cobanov/cyberdeck/cyberdeck.FCStd

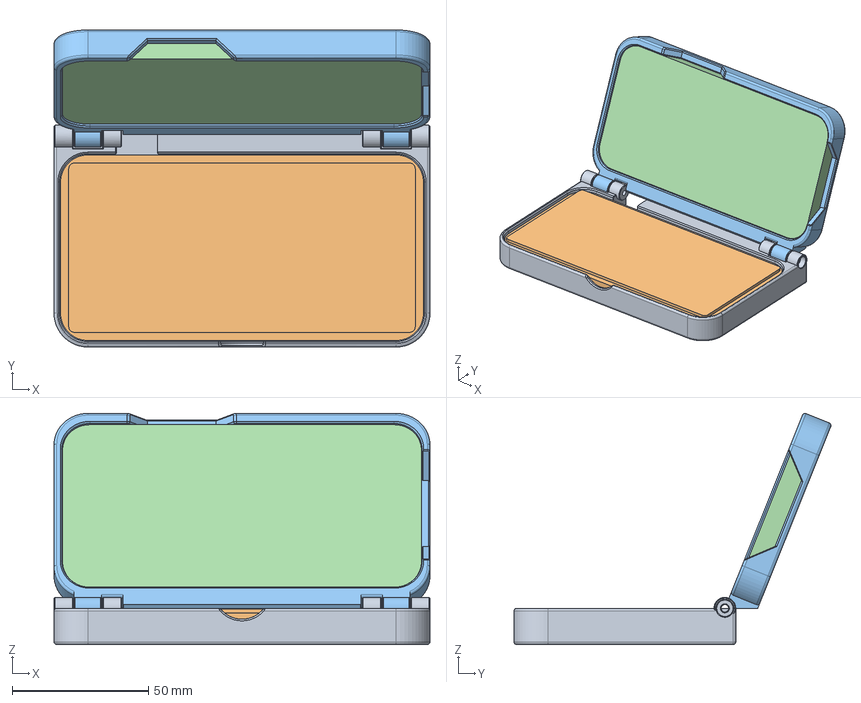
[picture p3: CAD file, 2026-11-02]
cyberdeck.FCStd
137.8 x 116.2 x 84.7 mm
Base
Keyboard
Lid
Phone
