cobanov/cyberdeck/render/lid.stl

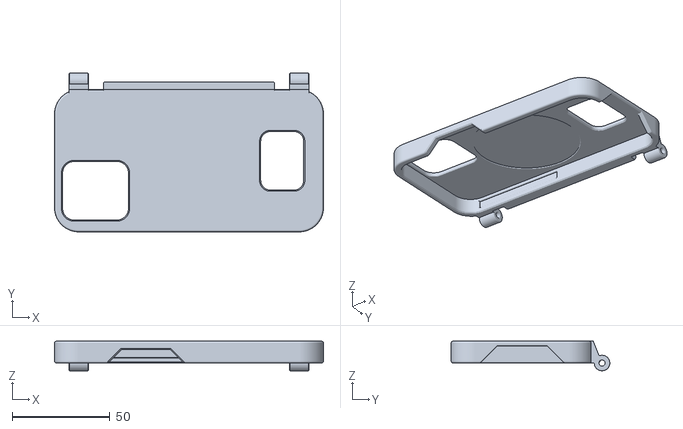
[picture p4: CAD file, 2026-11-02]
render/lid.stl
137.8 x 81.3 x 15.2
