cobanov/cyberdeck/render/slate/slate.stl

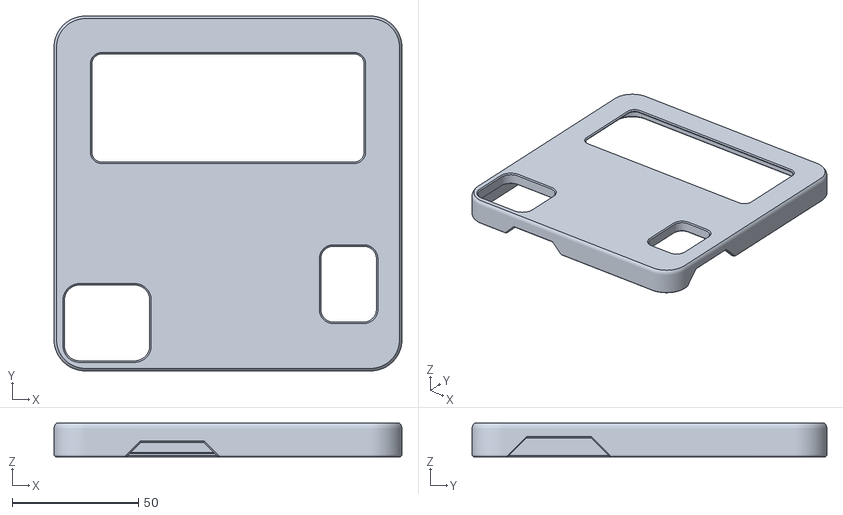
[picture p5: CAD file, 2026-11-02]
render/slate/slate.stl
137.8 x 140.5 x 13.4
