cobanov/cyberdeck/render/slide-in/phone.stl

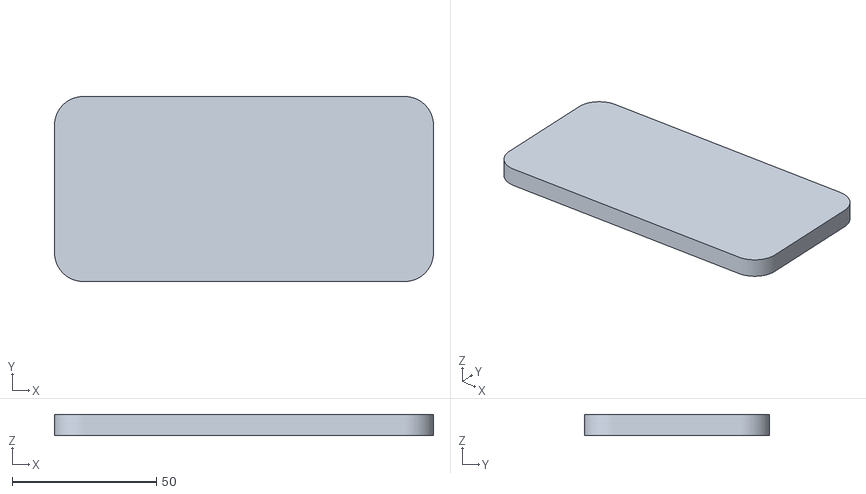
[picture p6: CAD file, 2026-10-31]
render/slide-in/phone.stl
131.5 x 64.2 x 7.40
