cobanov/cyberdeck/render/slide-in/slate/slate.stl

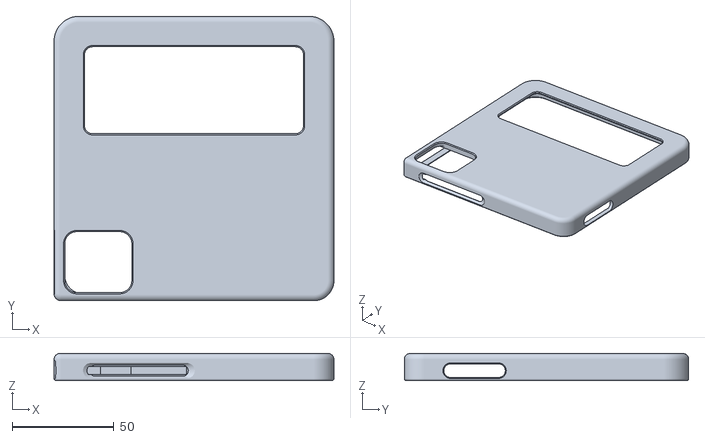
[picture p7: CAD file, 2026-11-01]
render/slide-in/slate/slate.stl
137.8 x 140.0 x 13.4
