cobanov/cyberdeck/stl/slide-in/slate.stl

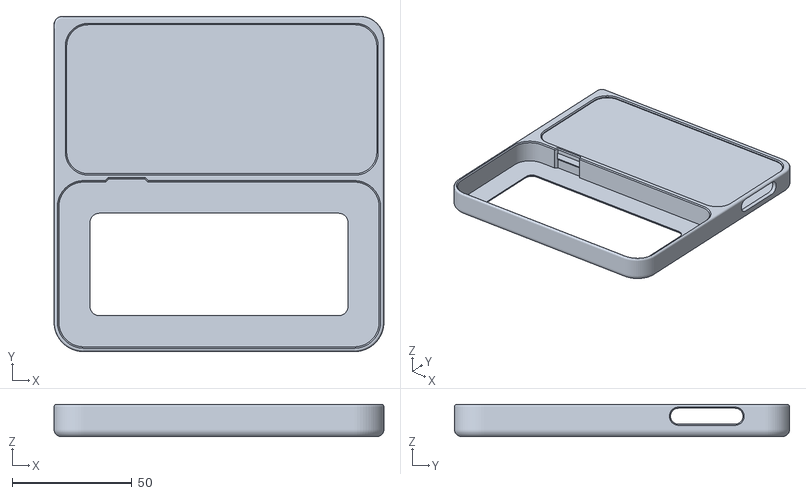
[picture p8: CAD file, 2026-11-01]
stl/slide-in/slate.stl
137.8 x 140.0 x 13.4
