cobanov/cyberdeck/render/base.stl

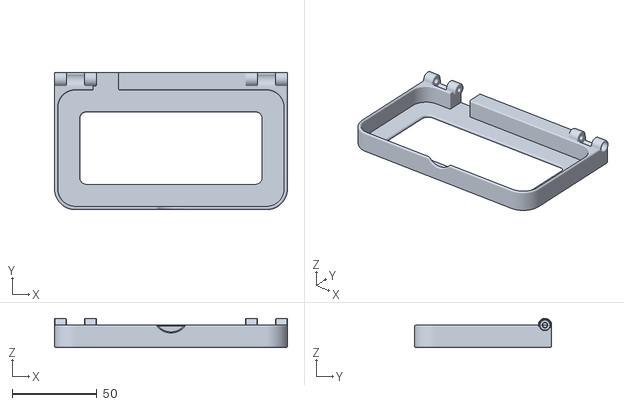
[picture p9: CAD file, 2026-11-01]
render/base.stl
137.8 x 81.3 x 17.3
