cobanov/cyberdeck/render/slide-in/lid.stl

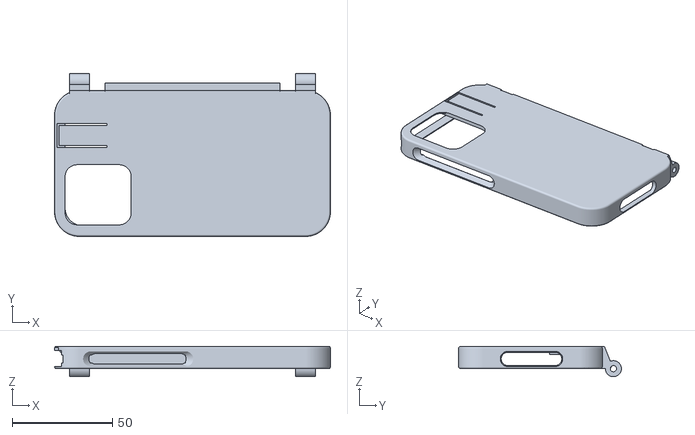
[picture p10: CAD file, 2026-10-31]
render/slide-in/lid.stl
137.8 x 81.3 x 15.2
