cobanov/cyberdeck/slate.FCStd

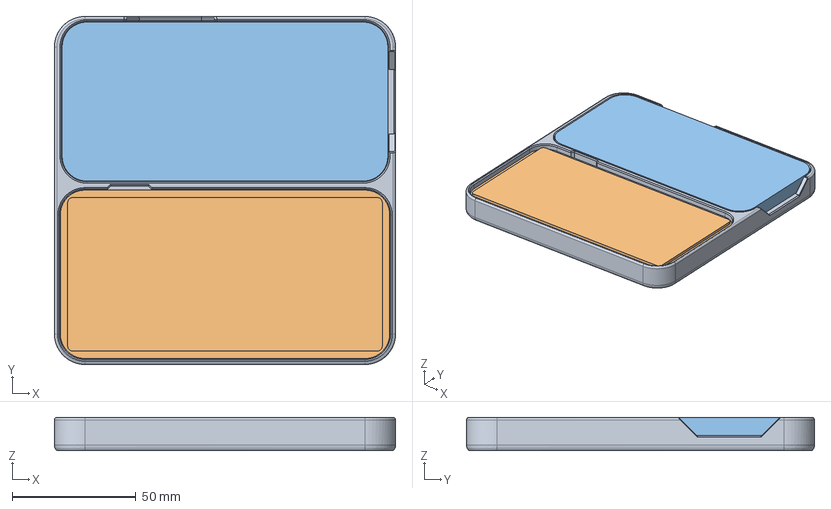
[picture p11: CAD file, 2026-11-02]
slate.FCStd
137.8 x 140.5 x 13.4 mm
Keyboard
Phone
