cobanov/cyberdeck/render/slate/kb_body.stl

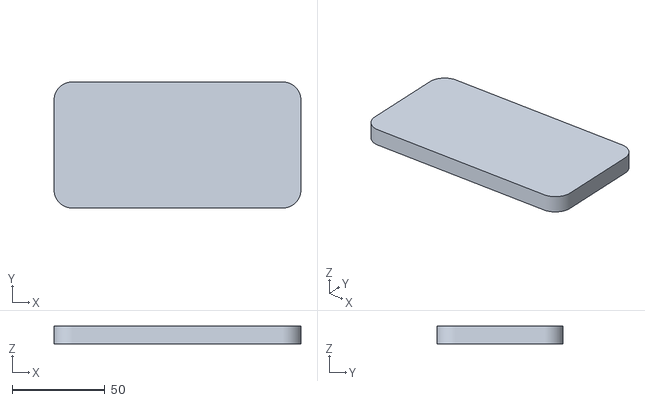
[picture p12: CAD file, 2026-11-01]
render/slate/kb_body.stl
133.0 x 68.0 x 9.50
