cobanov/cyberdeck/stl/fit_keyboard.stl

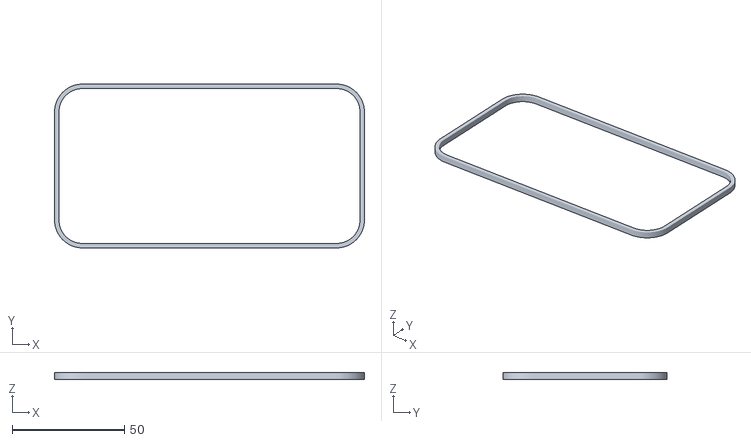
[picture p13: CAD file, 2026-10-29]
stl/fit_keyboard.stl
137.8 x 72.8 x 3.00
