cobanov/cyberdeck/stl/radius_gauge_case.stl

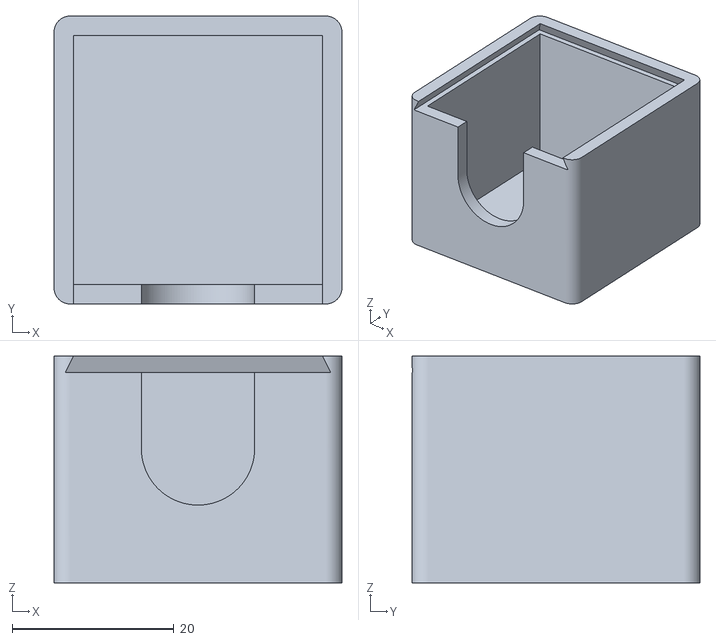
[picture p14: CAD file, 2026-10-29]
stl/radius_gauge_case.stl
35.6 x 35.6 x 28.0
