cobanov/cyberdeck/stl/radius_gauge_lid.stl

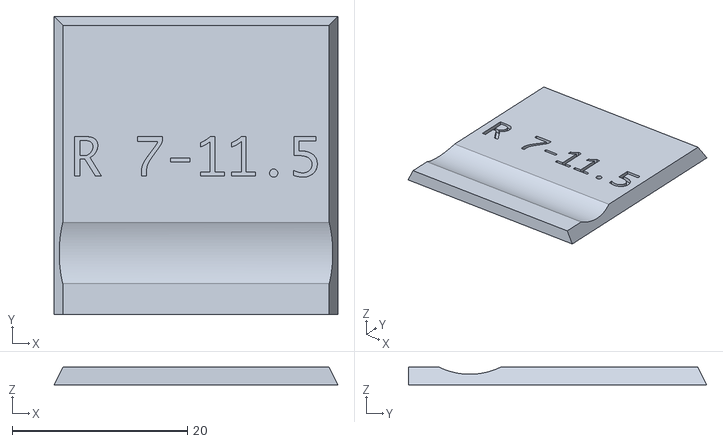
[picture p15: CAD file, 2026-10-29]
stl/radius_gauge_lid.stl
32.4 x 34.0 x 2.00
