cobanov/cyberdeck/stl/radius_gauge.stl

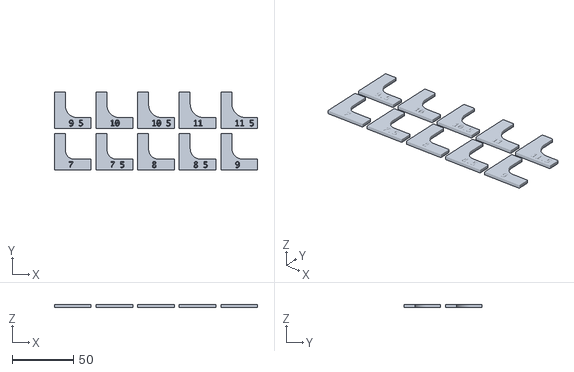
[picture p16: CAD file, 2026-10-28]
stl/radius_gauge.stl
166.0 x 64.0 x 2.40
