cobanov/cyberdeck/(list of files, cad)

Other CAD files:
stl/lid.stl
render/slate/phone.stl
render/slide-in/slate/phone.stl
stl/base.stl
stl/slide-in/lid.stl
render/phone.stl
render/kb_body.stl
stl/slate.stl
