cobanov/cyberdeck/(commit log)

2026-10-28 Clamshell cyberdeck for a Torima M7 keyboard and an iPhone 12 mini
    Parametric FreeCAD case: keyboard tray with a USB-C channel through the
    hinge foot, lid with slide-in rails and a flexing latch, two M3 screw
    hinges with a hard stop at 112 degrees. Self-checks assert the swing,
    the stop and both fits. Adds fit-test parts, a corner radius gauge, and
    a Blender room render built from the same meshes.
    Claude-Session: https://claude.ai/code/session_01PjqH8uNenf2NogwZJGJHBp
    [base.stl, cyberdeck.FCStd, cyberdeck.blend, fit_keyboard.stl, fit_phone.stl, kb_body.stl, lid.stl, phone.stl]
2026-10-28 Set the shared corner radius to an 11.5 mm estimate
    Pockets and front outer corners follow CORNER_R; back corners stay at
    6 mm so the hinge foot keeps its material, and the latch tongue moves
    onto the straight part of the phone's edge. Re-rendered.
    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
    [base.stl, cyberdeck.FCStd, cyberdeck.blend, fit_keyboard.stl, fit_phone.stl, kb_body.stl, lid.stl, phone.stl]
2026-10-28 Lock the lid at its 112 degree stop with magnets
    Each lid knuckle's landing face and the foot below it get a 6x2 mm
    magnet pocket that meet at the stop, so the lid snaps open and cannot
    wobble off it. The lid's hinge bore drops to 3.1 mm to take out the
    radial play on the screw shank.
    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
    [base.stl, cyberdeck.FCStd, fit_phone.stl, lid.stl]
2026-10-28 Give the lid a one-piece frame and move the lock magnets to a full web
    The screen lip now runs all the way round as one chamfered frame; the
    phone slides in above its left end. Full-height button and Lightning
    cuts become flared stadium windows, with relief grooves so the buttons
    aren't pressed while sliding. Outer edges of base and lid are rounded.
    A web across the lid's back now lands flat on the foot between the
    hinges and holds three pairs of 8x1 mm magnets, sizes the user has on
    hand. The self-check also slides the phone out to prove only the latch
    is in the way.
    Claude-Session: https://claude.ai/code/session_01PjqH8uNenf2NogwZJG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
    [base.stl, cyberdeck.FCStd, fit_phone.stl, lid.stl]
2026-10-28 Keep the lid's left end whole
    The latch slits and the camera channel ran out through the plate's left
    end and split it into claw-like pieces. The tongue's free end now sits
    just inside a strip at the end, and the camera bump slides along a
    blind groove into a window, so the end reads as one band.
    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
    [cyberdeck.FCStd, fit_phone.stl, lid.stl]
2026-10-28 Add the one-piece slate, shared phone bay, and print profiles
    slate.py is a 2DS-style handheld: the phone bay from the clamshell lid
    on top, and a keyboard pocket below that holds the keyboard under two
    fixed lips and two snap hooks, with push-out windows in the back. It
    prints back down without supports.
    The measurements, fits, and the phone bay move to deck.py so both
    builds share them; the clamshell's STLs come out byte-identical. The
    keyboard rim drops to 0.3 mm above the key tops so edge keys are easy
    to press. The lid renders in ruby red, the scene takes --slate and
    renders several named shots, and slice_k1.sh slices every part for
    the K1 with checked PLA settings.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
    [base.stl, cyberdeck.FCStd, fit_phone.stl, fit_slate_keyboard.stl, kb_body.stl, lid.stl, phone.stl, slate.FCStd]
2026-10-29 Render portrait frames on request
    An aspect argument such as 9:16 renders every shot as a portrait frame
    into render/aspect/ (not tracked). The camera keeps the landscape
    shots' horizontal view and zooms in per shot, so the taller frame adds
    room and desk instead of cropping the deck.
    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
2026-10-29 Make every part print cleanly on the K1
    A printability pass over the sliced G-code found three faults:
    - The frame lip's left end, a 65 mm bridge over the phone slot, was
    printed in short strands hung from the side lips. It now starts one
    layer higher, so the slicer bridges it wall to wall, and the step
    leaves room for sag.
    - The slate's latch tongue was thinned from the back, which left it
    printing over air. The recess now opens to the phone's side, with a
    45 deg far end so the phone's edge rides out of it.
    - The slate's hook tabs flexed across the layers, where PLA is weakest.
    Each hook now sits on an 18 mm arm that bends sideways, along the
    layers, at under 1 % strain. The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
    [cyberdeck.FCStd, fit_phone.stl, fit_slate_keyboard.stl, lid.stl, slate.FCStd, slate.stl]
2026-10-29 Give the radius gauge a case
    Ten loose tiles get lost. They now stack in a small box whose lid
    slides in along dovetail grooves; a U-cut in the front wall lets
    fingers pinch the tiles out. Box and lid print without supports, on
    their own plate so the gauge itself still prints first in 36 min.
    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
    [radius_gauge_case.stl, radius_gauge_lid.stl]
2026-10-29 Slice with the PLA @K1 cobanov preset and safer plates
    The filament profile is now the shared PLA @K1 cobanov preset (Elas
    PLA Pro values: 225 C first layer, flow 1.025, PA 0.05, 13 mm3/s).
    slice_k1.sh checks those values in every G-code too.
    Three parts on one plate made OrcaSlicer push one to a second plate,
    which the script silently dropped. It now stops when parts spill over,
    and the tests go on two plates: the radius gauge with the phone bay
    test first, then both keyboard tests.
    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
2026-10-29 Print without brims or skirts
    The K1's START_PRINT draws its own purge line, so a skirt adds nothing,
    and every part here sits on the bed wide and low enough to hold without
    a brim. A zero-gap brim also fused to the radius gauge's measuring
    edges.
    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
2026-10-29 Keep unreadable devices, forget host keys only on save, share one device check
    - An unreadable saved device list is kept under servers.unreadable instead of
    being written over by the next save; a test pins today's saved format.
    - "Host anahtarını unut" applies on Kaydet, so Vazgeç undoes it, and it
    forgets the pin of the device as opened, not as edited.
    - The form and backup restore use one check, Server.cleaned, so a restored
    device is trimmed like a typed one.
    - Backup reads and writes pins through Pins.all.
    Claude-Session: https://claude.ai/code/session_01PjqH8t3ZJrSBGJEy4NMw1a
2026-10-29 Use the measured 10 mm corner radius, and cool the lip bridges
    The radius gauge puts the corners of both the keyboard and the iPhone
    12 mini at 10 mm, not the 11.5 mm estimate, so every part is rebuilt
    from that.
    The phone bay test fit, but its left-end lip sagged slightly onto the
    screen: the lips bridge 60-120 mm with only the part fan cooling them.
    slice_k1.sh now turns the side fan on for bridges only, since the
    preset keeps it off to stop it blowing on the bed.
    The fit tests are split by build now that the gauge is printed: the
    clamshell's two on one plate, the slate's on its own.
    Claude-Session: https://claude.ai/code/session_0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
    [base.stl, cyberdeck.FCStd, fit_keyboard.stl, fit_phone.stl, fit_slate_keyboard.stl, kb_body.stl, lid.stl, phone.stl]
2026-10-29 Cut the home page down to the core
    The hero, the two decks and three short points: keyboard first, private, safe
    connections. Themes, fonts, gestures, the key bar, the shortcut table, the tip
    section and the questions go (the support page keeps the answers), with their
    CSS and the two screenshots only they used.
    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
2026-10-29 Keep sessions open, show each host's logo, and fix the side gaps
    - Sessions outlive the terminal screen: going back keeps them, the key bar
    gets a tab per session, and ⌘1–9 switch from anywhere.
    - One short `uname -s; cat /etc/os-release` after connecting picks the
    host's logo (Simple Icons, CC0); the privacy page says so.
    - The camera's inset stays on its own side only, so the panel, key bar and
    list no longer leave a blank strip on the other.
    - No devices shows the welcome screen, without a close button or Not now.
    - A one-time hint over the first terminal explains the edge swipes.
    - English only; forms and menus use the system font again.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
2026-10-29 Add the App Review demo server, and show sessions and logos on the site
    - app/demo-server: the Ubuntu container App Review signs in to on nuc. One
    password user, no sudo, pinned host keys kept in a volume, and a mangle
    rule that drops every connection it starts. A timer keeps
    demo.deckterm.cobanov.dev on the home IP.
    - Home page: the new terminal shot with its session tab, and the key line
    now says ⌘1–9 switches between open sessions.
    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
2026-10-29 Keep the device list header clear of the iPad window controls
    iPadOS draws its window controls over the top-leading corner of an iPhone
    app and reports no safe area inset for them, so on iPad the header starts
    56 pt in. App Review runs iPhone apps on an iPad Air.
    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
2026-10-31 Let the phone slide fully home, and ramp the volume-button window
    The first full lid printed cleanly, but the phone stopped 1-2 mm short of the
    closed right end, so the latch bump only half caught its left edge. The two
    things that could stop it get room: the bay's right-end corners are 2 mm
    tighter than the phone's (a tighter corner can't bind, it only leaves a gap
    under the lip), and the camera groove and window run 2 mm further.
    The volume-button window's ends now ramp at ~45 deg so a fingertip reaches
    the buttons; across the wall it flares 1.2 mm to keep the screen-face edge.
    The base is unchanged, so a base printed now fits both lids.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
    [cyberdeck.FCStd, fit_phone.stl, lid.stl, slate.FCStd, slate.stl]
2026-10-31 End the base at the hinge, and add cyberdeck.cobanov.dev
    The 14 mm hinge foot behind the keyboard looked bulky. The base now ends at
    the hinge pins, 81 mm deep instead of 91. With the foot go the open-lock
    magnets: open, the lid and phone weigh behind the axis, so gravity keeps the
    lid on its stop, and the script now asserts that. The lid lands on a 2.5 mm
    strip behind the axis, whose back edge stays square so all of it is flat.
    Where the lid knuckle's groove runs out of the back face, a flat floor
    replaces a 27 deg knife edge.
    site/ is cyberdeck.cobanov.dev: a three.js viewer that opens and closes the
    clamshell, and the STLs to download. site/deploy.sh publishes the models
    from the last co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
    [base.stl, cyberdeck.FCStd, lid.stl]
2026-10-31 Redraw the slate, measure the keys, and restyle the site
    The first slate printed without supports, its frame lips sagged, the phone latch
    broke and the keyboard sat too deep. The slate now has no latch (the phone is held
    by its snug fit), presses the keyboard in flush like the clamshell base, keeps
    2 mm walls round the phone (shallower side-key window) and is 11.6 mm thick
    instead of 14.4. The bay's mouth gets a smaller outer corner and a 45 degree
    lead-in, so the rails no longer end in a knife edge. It slices with
    profiles/k1_slate_process.json: tree supports on the part under the lips, the
    screen face ironed. The slate's keyboard fit test is gone with its lips and hooks.
    The keys were rem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
    [base.stl, cyberdeck.FCStd, fit_phone.stl, fit_slate_keyboard.stl, kb_body.stl, lid.stl, phone.stl, slate.FCStd]
2026-11-01 Offer the deck in four colours, and fix the renders' screen and keys
    The renders cut every rounded rectangle's corners at 45 degrees (a vertex bevel),
    so the phone's metallic face showed through as grey patches round the screen and
    its navy glow met a black border and a grey notch. The screen is now one black
    glass sheet over the whole face, as an OLED with a black terminal looks, and the
    camera window shows the lenses and flash instead of a flat black square. The keys
    start 5 mm in from the keyboard's edge (was 3), as on the real one.
    scene.py takes --color=white|mint|black (default red; the clamshell base stays
    charcoal). The site gets four swatches that paint the viewer's model and swap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
2026-11-01 Sink the slate's keyboard 1.2 mm, and print its frame lips on a skin
    The white slate v2 showed two faults. Its keyboard housing stayed 0.5-1 mm
    proud and sprang back out: the pocket was exactly the housing's depth, so the
    housing's top edge never got inside for the walls to grip. The pocket is now
    1.2 mm deeper (KB_SINK); the floor behind the keyboard is 1.2 mm instead of 2,
    so the slate grows only from 11.6 to 12 mm.
    The tree supports allowed on the part grew inside the phone bay and left a
    continuous interface strip under the 1.5 mm lips, one layer below them, that
    could be neither pulled nor broken out. The print STL now closes the screen
    window with a one-layer skin at the lips' undersi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
    [kb_body.stl, slate.FCStd, slate.stl]
2026-11-01 Notch the slate for the keyboard's USB-C, chamfer its sharp edges, and show parts and supports in the viewer
    The third slate's keyboard still sat flush: the clamshell base has a slot at the keyboard's USB-C port, the slate had
    none. It gets a 45-degree-ended notch there and a pocket 1.5 mm deeper (13.4 mm thick). The frame over the phone bay's
    open end still sagged, so tree supports return, from the bed only, and a first-layer skin closes the camera window so
    none climb into the bay. The keyboard pocket's rim and the back windows are chamfered; at the bay's mouth the frame
    gets a ramp, the camera groove a lead-in, and the button groove no longer runs out in a knife edge.
    The site's viewer g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
    [kb_body.stl, skins.stl, slate.FCStd, slate.stl]
2026-11-01 Re-render the slate at 13.4 mm with the sunken keyboard and chamfers
    Claude-Session: https://claude.ai/code/session_01PjqH8s3wqMgzZZQK7QTT6E
2026-11-01 Hold the phone with MagSafe in both builds, and chamfer every square edge
    The phone now drops screen out into an open pocket, and its own MagSafe
    magnets hold it to a steel ring sticker in a 58 mm recess in the floor.
    The slide-in bay, its latch, frame lips, skins and the slate's supports
    are gone, and so is the phone fit test. deck.py holds the pocket, its
    self-checks and the chamfering for both builds.
    - Slate: screen flush with the face, no supports or bridges, 141 mm long,
    1 h 33 min and 53 g. Every convex square edge is chamfered 0.6 mm
    (0.3 mm where there's no room).
    - Clamshell lid: the same pocket with the screen 1.2 mm in, so the
    closed lid keeps it 1.5 mm off the keys. Its t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
    [cyberdeck.FCStd, fit_phone.stl, lid.stl, phone.stl, skins.stl, slate.FCStd, slate.stl]
2026-11-01 Show the two builds first, in mint, and the viewer as a two-way switch
    - The renders move up under the hero; the 3D viewer follows them.
    - The viewer offers only the clamshell and the slate, as a centred
    switch. The base, lid and radius gauge views are gone, and with the
    lid view the slicer's supports, so render/supports.py goes too.
    - Mint is the default colour and the site's accent.
    - Keyboard and phone start hidden so the pockets show; tick to add.
    - Footer labels in sentence case, 4 px steps on the controls.
    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
2026-11-01 Tidy the repo for release: a short README, portable scripts, no generated renders
    - README rewritten short: the two builds, what you need, print, assemble,
    change it, renders and site, status. It shows the mint renders the
    site uses.
    - The scripts find the repo from their own path instead of a fixed
    /Volumes path, so a clone runs as is (freecadcmd slate.py).
    - The full-size renders are outputs of render/scene.py and were
    re-committed at 5 MB each on every change; they're ignored now. The
    unused render/cyberdeck.blend and PH_SCREEN go too.
    - The site's links into the README follow its new headings.
    Claude-Session: https://clau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
    [cyberdeck.FCStd, cyberdeck.blend, slate.FCStd]
2026-11-01 Chamfer the clamshell's square edges too
    The base and the whole lid now go through chamfer_sharp like the slate:
    0.6 mm on the keyboard pocket, the push-out window, the finger notch and
    the USB-C slot; 0.3 mm on the hinge's knuckles, grooves and web. Square
    on purpose: the strips where the lid's web lands at the stop (0.1 mm
    there tilts the open lid ~2 deg), and the few hinge edges where even
    0.3 mm fails, all upright or on the bed in print. Asserts unchanged and
    passing; base 57 min / 32 g, lid 1 h 4 min / 34 g.
    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
    [base.stl, cyberdeck.FCStd, lid.stl]
2026-11-02 Offer the slide-in builds again, link DeckTerm and GitHub, and ask for help with the hinge
    The site shows four builds: the MagSafe clamshell and slate, and the earlier slide-in versions from b10fc7d, in red, for
    people without a ring sticker. The hero links DeckTerm and GitHub, and a note asks hinge designers for help.
    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
    [lid.stl, phone.stl, slate.stl]
2026-11-02 Centre the side-key slot on Apple's drawing, tighten the phone pocket, and chamfer the slate's bed edge
    The printed MagSafe slate showed three faults. Apple's iPhone 12 mini dimensional drawing puts the side button 43.68 mm
    from the top edge, 6 mm from where the slot was; check_pocket now asserts the button clears it. The phone moved in its
    pocket, so its clearance is 0.25 mm (was 0.5). The camera corner lifted: the 3 mm round left a 1.8 mm first-layer strip
    there, so a 1 mm chamfer now meets the bed under it. The drawing also confirms MagSafe sits at the phone's centre.
    Claude-Session: https://claude.ai/code/session_01PjqH8s3wqMgzZZQK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
    [cyberdeck.FCStd, lid.stl, phone.stl, slate.FCStd, slate.stl]
2026-11-02 Put the clamshell beside the headline, and quiet the site's chrome
    The hero splits in two: the copy and three buttons on the left, a new mint front render on the right. "Read the build
    notes" went to the same repo as GitHub, so it's gone; GitHub is an outlined button. The hinge note keeps its yellow
    label but a quieter border. Text links are underlined ink instead of mint, captions set their measurements in mono,
    headings and captions lose their full stops, and the spacing sits on a 4 px grid.
    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
2026-11-02 Run the hinge note across the page, edge to edge with the hero
    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
2026-11-02 Link the clamshell and slate on Printables from the files section and footer
    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
